christofel04/High-Precision-Oscillator-Circuit/messageImage_1573116734108.jpg

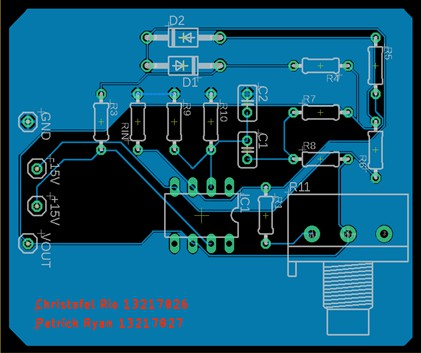
messageImage_1573116734108.jpg
