christofel04/High-Precision-Oscillator-Circuit/EL3109_06_13217026.pdf

Laporan Praktikum - Laboratorium Dasar Teknik Elektro – STEI ITB 1

MODUL 6 Mendesain Osilator RC Christofel Rio Goenawan (13217026) Asisten: Yoseph A. Adel P. (13216048) Tanggal Percobaan: Rabu, 30 Oktober 2019 EL3109- Praktikum Elektronika II

### Laboratorium Dasar Teknik Elektro - Sekolah Teknik Elektro dan Informatika ITB

Abstrak

Pada zaman modern ini, segala sesuatu memakai sistem elektrik. Mulai dari alarm yang membangunkan kita, gadget di genggaman tangan Anda, hingga pengendali pesawat luar angkasa memakai sistem elektris. Salah satu sistem yang paling sering dipakai dalam rangkaian elektrik adalah sistem osilator. Secara singkat sistem osilator adalah sistem rangkaian elektrk yang mengubah input arus atau tegangan searah menjadi arus atau tegangan bolak- balik
pada | outputnya. | Pada | umumnya | sistem | osilator
menggunakan komponen resistor, kapasitor, dan operating amplifier atau biasa disebut “op amp”. Selain rangkaian osilator pada umumnya, terdapat juga rangkaian osilator dengan umpan balik yang menawarkan berbagai kelebihan seperti pengaturan osilasi, pengaturan amplifikasi, dan pengaturan noise. Sistem osilator sangat berguan dalam dunia elektronika karena mengubah sumber DC yang diterima sebuah benda menjadi sinyal AC yang dapat dimanfaatkan dalam berbagai hal. Karena kegunaannya yang sangat penting dalam dunia elektro tersebut, maka penting bagi seorang engineer elektro untuk dapat menguasai cara analisis rangkaian osilator dengan umpan balik, karakteristik rangkaian osilator dengan umpan balik, dan mampu merancang suatu rangkaian osilator dengan umpan balik untuk suatu kebutuhan tertentu. Karena alasan- alasan di atas, maka penulis akan melakukan percobaan modul 4 ini. Diharapkan dengan adanya percobaan modul 4 ini maka penulis akan mengerti karakteristik rangkaian osilator dengan umpan balik, mampu menganalisis suatu rangkaian osilator dengan umpan balik, dan mampu mendesain suatu rangkaian osilator dengan umpan balik tertentu untuk
memenuhi | suatu | kebutuhan | tertentu.

Kata kunci: Rangkaian Elektrik, Rangkaian Osilator dengan Umpan Balik, Analisis, Mendesain, Menguasai.

### 1. PENDAHULUAN

Seperti yang telah dibahas sebelumnya, sistem elektrik menjadi kebutuhan tiap manusia saat ini. Dalam sistem elektrik, rangkaian elektrik adalah ‘roh’ . Dalam dunia rangkaian elektrik, Salah satu sistem yang paling sering dipakai dalam rangkaian elektrik adalah sistem osilator. Secara singkat sistem osilator adalah sistem rangkaian elektrik yang mengubah input arus atau tegangan searah menjadi arus atau tegangan bolak- balik pada outputnya. Pada umumnya sistem osilator menggunakan komponen resistor, kapasitor, dan operating amplifier atau biasa disebut “op amp”. Selain rangkaian osilator pada umumnya, terdapat juga rangkaian osilator dengan umpan balik yang menawarkan berbagai kelebihan seperti pengaturan osilasi, pengaturan amplifikasi, dan pengaturan noise. Sistem osilator sangat berguna dalam dunia elektronika karena mengubah sumber DC yang diterima sebuah
benda | menjadi | sinyal | AC | yang | dapat
dimanfaatkan dalam | berbagai | hal. Karena
kegunaannya yang sangat penting dalam dunia elektro tersebut, maka penting bagi seorang engineer elektro untuk dapat menguasai cara analisis rangkaian osilator dengan umpan balik, karakteristik rangkaian osilator dengan umpan balik, dan mampu merancang suatu rangkaian osilator dengan umpan balik untuk suatu kebutuhan tertentu. Karena alasan- alasan di atas, maka penulis akan melakukan percobaan modul 4 ini.

Dengan alasan- alasan di atas, maka penulis akan melakukan percobaan modul 6 ini. Secara umum terdapat 1 percobaan pada praktikum ini, yaitu: I) Pencobaan mendesain osilator Wien.

Pada percobaan pertama, yaitu percobaan mendesain osilator Wien, Penulis akan memasang rangkaian penguat common emitter dengan kapasitor bypass tepat seperti pada modul, kemudian Penulis akan mengukur sinyal output, penguatan, frekuensi cut- off dan resistansi input rangkaian tersebut. Kemudian Penulis akan mengubah rangkaian tersebut menjadi rangkaian transistor dengan umpan balik, kemudian Penulis akan kembali mengukur parameter seperti sebelumnya. Terakhir, Penulis akan mengubah rangkaian menjadi rangkaian dengan umpan balik
lainnya, | lalu | mengukur | parameter | seperti
sebelumnya sesuai dengan jenis umpab balik rangkaian tersebut. Tujuan dari percobaan ini adalah agar Penulis memahami cara kerja umpan
balik | pada rangkaian, memahami jenis- jensi
rangkaian | umpan | balik | transistor | dan
karakteristik | masing- | masing, | mampu
menganalisis kerja rangkaian transistor dengan umpan balik, dan mampu mendesain suatu rangkaian umpan balik transistor untuk suatu pekerjaan tertentu.

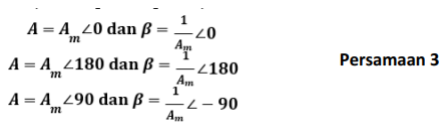
[picture p2: figure]
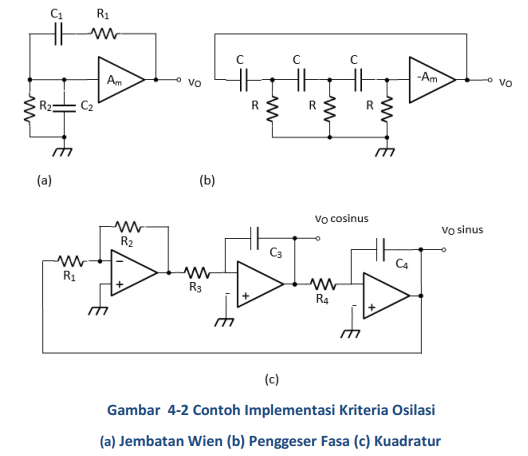
[picture p3: figure]
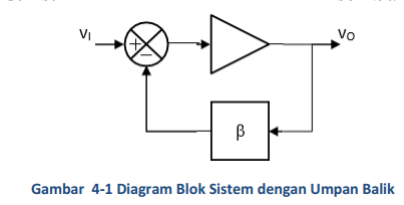
[picture p4: figure]

Laporan Praktikum - Laboratorium Dasar Teknik Elektro – STEI ITB 2

### 2. STUDI PUSTAKA

### 2.1 RANGKAIAN OSILATOR

Ada banyak cara untuk mencapai kriteria
terjadinya | osilasi | di | atas, | namun | untuk
kemudahannya dalam perancangan sering kali dipilih keadaan-keadaan berikut:

Contoh implementasi untuk ketiga keadaan tersebut di atas, secara berurutan adalah Osilator Jembatan Wien, Osilator Penggeser Fasa, dan Osilator Kuadratur yang rangkaian umumnya tampak pada Gambar 4-2.

Osilator Jembatan Wien secara umum mempunyai
frekuensi | osilasi | dan | penguatan | yang
diperlukan untuk terjadinya osilasi sebagai berikut:

Dalam realisasinya, dalam merancang Osilator Jembatan Wien sering kali dipilih R1=R2=R dan C1=C2=C sehingg frekuensi osilasinya menjadi ω=1/CR dan penguatan yang diperlukan Am=3. Nilai lain yang juga sering digunakan adalah R1=R, R2=10R, C1=C/10, dan C2=10C dengan frekuensi osilasi yang sama yaitu ω=1/CR namun
penguatan | hanya | Am=1,2.
Untuk Osilator Penggeser Fasa frekuensi osilasi dan penguatan yang diperlukan adalah

Sedangkan untuk osilator kuadratur frekuensi osilasinya adalah

dan untuk masing-masing integrator (inverting dan noninverting) penguatannya adalah

Dalam perancangannya bila dipilih R1=R2=R, R3=R4 dan C3=C4 maka diperoleh penguatan pada
masing-masing opamp 1 (satu) dan penguatan loop terbuka juga 1 (satu)

### 2.2 RANGKAIAN OSILATOR DENGAN

UMPAN BALIK

Sistem dengan umpan balik secara umum dapat
digambarkan | dengan | diagram | blok | pada
Gambar | | 4-1 | | berikut.

Blok A merupakan fungsi transfer maju dan blok merupakan fungsi transfer umpan baliknya. Pada sistem dengan umpan balik ini dapat diturunkan penguatan tegangannya:

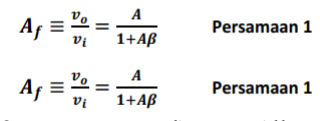
[picture p5: figure]
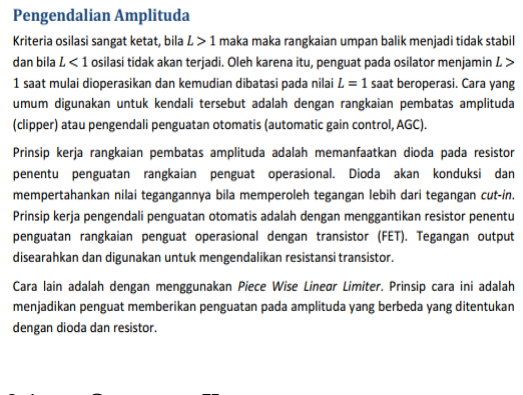
[picture p6: figure]

Laporan Praktikum - Laboratorium Dasar Teknik Elektro – STEI ITB 3

Secara umum persamaan di atas menunjukkan adanya tiga keadaan yang ditentukan oleh denominatornya. Salah satu keadaan tersebut adalah saat denominator menjadi nol. Saat itu nilai Af menjadi tak hingga. Secara matematis pada keadaan ini bila diberikan sinyal input nol atau vi=0 ini, akan menjadikan tegangan vo dapat bernilai berapa saja. Keadaan seperti inilah yang menjadi prinsip pembangkitan sinyal atau osilator sinusoidal dengan umpan balik yang disebut sebagai Kriteria Barkhausen. Dalam rangkaian kriteria tersebut dilihat dari total
penguatan | loop | terbuka | L | sbb.:

### 2.3 PENGENDALIAN AMPLITUDO PADA

RANGKAIAN OSILATOR DENGAN
UMPAN BALIK

### 2.4. OSILATOR KUADRATUR

Untuk menghasilkan keluaran quadrature dari rangkaian osilator cincin single ended diperlukan jumlah tahap yang genap,tetapi jumlah tahap yang genap tidak akan bisa berosilasi karena mempunyai keadaan stabil yang disebut latch-up. Untuk mencegah keadaan latch up, yang pertama dengan menggunkan sel tunda CML(current mode logic) yang
mempunyai sebuah transistor tail current source [16]. Cara kedua dengan menggunakan teknik injection locking. Cara
ketiga dengan menambahkan jalur feed forward atau subfeedback pada nodal yang mempunyai fase berlawanan [10].
Cara pertama mempunyai kelemahan, yaitu konsumsi daya yang lebih besar karena penggunaan arus bias yang konstan
pada transistor tail, sedangkan injection locking memerlukan input berupa sinyal diferensial. Oleh karena itu dalam paper
ini digunakan cara ketiga yaitu menambahkan jalur atau kalang umpan balik sub-feedback. Osilator rancangan menggunakan single-ended inverter empat tahap untuk menghasilkan keluaran quadrature,
meskinpun dapat juga dilihat sebagai differential inverter dua tahap dengan sub-feedback index x = 3 [11]. Di mana x
merepresentasikan jumlah inverter dalam kalang umpan balik.

Dalam rancangan ini, rangkaian umpan balik terdiri dari INV2, INV3 dan f2. Dengan membentuk kalang umpan balik subfeedback dua buah sinyal dengan fase yang berbeda 1800 akan bertemu sehingga membentuk sebuah rangkaian regenerative
yang akan membuat osilator dengan jumlah tahap yang genap 56 JNTETI, Vol. 1 No. 2, Agustus 2012 ISSN 2301 – 4156 Rangkaian Osilator Cincin... tetap bisa berosilasi dan mengeluarkan sinyal. Kalang Subfeedback juga bisa digunakan untuk membuat jalur cepat sehingga mengurangi waktu tunda dan akibatnya bias meningkatkan frekuensi [10], [11]. Hal ini bisa dijelaskan sebagai berikut, ketika keluaran dari INV2 belum mencapai tegangan ambang (threshold), keluaran dari f2 sudah mencapai tegangan ambang terlebih dahulu, sehingga tegangan keluaran pada X2 dapat mencapai tegangan ambang terlebih dahulu sesuai dengan tegangan keluaran dari f2, sehingga menyebabkan periode sinyal keluaran atau waktu tunda menjadi lebih kecil dan akhirnya dapat meningkat kan frekuensi keluaran.

### 3. METODOLOGI

### 3.1. ALAT DAN BAHAN

Berikut alat dan bahan yang dipakai pada percobaan ini.

1. Kit Praktikun Osilator Sinusoidal
2. 1x Generator Sinyal 2 channel
3. 2 x Sumber Tegangan DC
4. 1x Osiloskop 2 channel
5. 1x Multimeter Digital SANWA CD800A
6. 1x Multimeter Analog SANWA YX360TRF

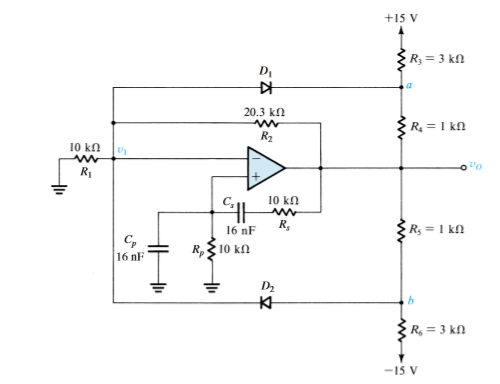
[picture p7: figure]
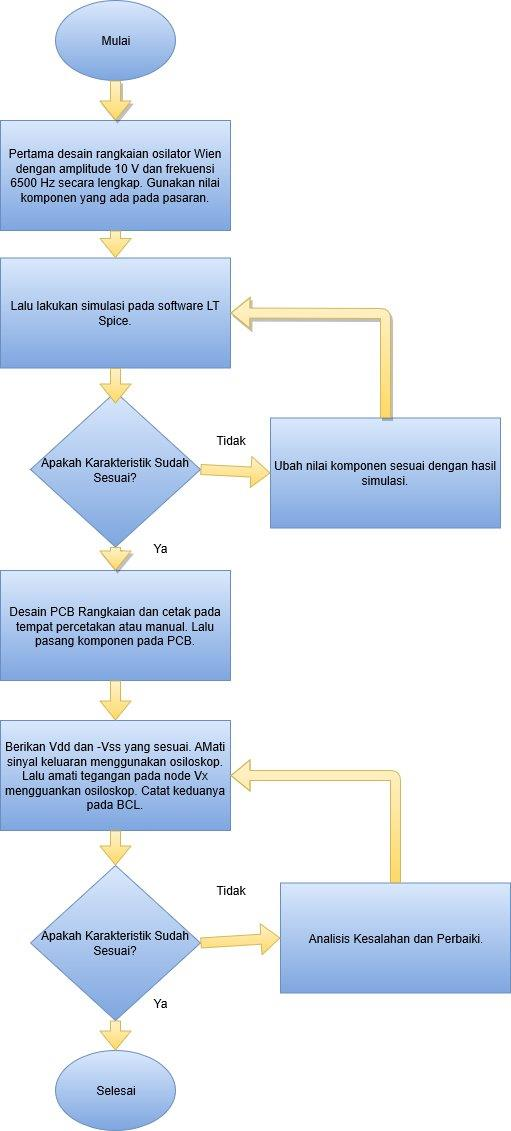
[picture p8: figure]

Laporan Praktikum - Laboratorium Dasar Teknik Elektro – STEI ITB 4

7. 1x Multimeter Bench
8. 1x Aerosol Udara Terkompresi
9. 1x Resistor Variabel
10. Kabel BNC- BNC, BNC- Buaya,
Buaya- | Buaya, | jumper
secukupnya

### 3.2. LANGKAH PERCOBAAN

### 3.2.1 PERCOBAAN 1: PERCOBAAN MENDESAIN

OSILATOR WIEN

Alat yang dibutuhkan: Kit Praktikum Osilator Sinusoidal, Generator Sinyal 2 channel, Sumber Tegangan DC, Osiloskop 2 channel, 3 macam Multimeter, kabel dan jumper secukupnya.

Langkah Percobaan:

### 3.3. DESAIN RANGKAIAN

Penulis akan mendesain suatu osilator Wien dengan frekuensi 6,5 KHz dan amplitude output 10 V. Untuk mendesain osilator Wien dengan amplitude tertentu Penulis menggunakan rangkaian osilator Wien dengan diode sebagai pembatas tegangan sederhana. Rangkaian umum osilator ini adalah sebagai berikut [1, halaman 1390].

Berdasarkan teori dapat kita lihat bahwa penurunan penguatan loop gain rangkaian di atas dengan mengabaikan diode dan resistor 5 dan 6 adalah sebagai berikut ( misalkan feedback R2 dipotong dan diberi tegangan sebesar Vt ). Dengan KCL pada node V1 (dengan asumsi op amp ideal sehingga tidak ada arus yang mengalir pada input negative dan positif dan tegangan pada kedua input sama):

V1/R1 = (Vt – V1)/R2

- V1/Vt = R1/(R1+R2)

Kemudian dengan KCL pada node Vo:

(Vo – V1 )/(Rs + 1/(Cs*s)) = V1/(1/(1/Rp + Cp*s))

Dengan memasang Cp= Cs dan Rp = Rs didapat turunan sebagai berikut.

- Vo/ V1 = 3 + RCs + 1/(RCs)

Dengan mengalikan dua persamaan didapat hubungan sebagai berikut.

Laporan Praktikum - Laboratorium Dasar Teknik Elektro – STEI ITB 5

L= V0/Vt

= Vo/V1 * V1/Vt

= (R1/(R1+R2)) * (3 + RCs + 1/(RCs))

- L(Wj) = (R1/(R1+R2)) * (3 + j(RCW – 1/(RCW)))

Berdasarkan teori pada referensi [1, halaman 1389] didapat bahwa osilasi terjadi hanya saat nilai L adalah bilangan real dan nilainya tepat sama dengan 1. Maka didapatkan sebagai berikut.

i) Im(L) = 0

Maka haruslah RCW – 1/RCW = 0, yang ekivalen sebagai berikut.

RCW = 1/RCW

- W = 1/RC

ii) Re(L) =1

Maka haruslah sebagai berikut.

3*R1/(R1+R2) = 1

- 3*R1 = R1 + R2
- R2 = 2*R1

Sedangkan untuk mengatur amplitudonya, digunakan diode seperti pada gambar di atas. Adapun cara kerja pembatas diode adalah pada saat tegangan positif maksimal ( Vmax) tegangan pada node b akan melebihi tegangan pada V1 ( yang berdasar teori seharusnya 1/3* Vo) dan diode D2 akan konduksi. Hal ini akan membuat tegangan maksimal akan ditentukan oleh nilai resistor R5 dan R6 dan tegangan – Vss sebagai berikut.

Vb = V1 + Vd2

Dengan Vd2 adalah tegangan drop voltages pada diode D2 saat forward biase. Sehingga hal dengan mengasumsikan Vd2 = 0,7 V maka dengan KCL pada node b didapat output persamaan sebagai berikut.

Vb – (-Vss)/R6 = (Vo – Vb)/R5

- (Vo/3 + 0,7 -(- Vss) )/R6 = (Vo – Vo/3 – 0,7)/R5

Dengan menggunakan nilai Vdd= 15 V dan – Vss = -15 V didapat hubungan sebagai berikut.

(Vo/3 + 15,7)/R6 = (2/3 * Vo – 0,7)/R5

- Vo = 3*(15,7/R6 + 0,7/R5)/(2/R5 – 1/R6)
- Vo = 3*(15,7 *R5 + 0,7*R6)(2*R6-R5)

Adapun untuk tegangan minimum sama dengan perhitungan tegangan maksimum.

Dari persamaan di atas dapat kita rancangan osilator Wien dengan karakteristik sebagai berikut.

i) F = 6500 Hz

Maka didapat hubungan:

F = W/2*pi

= 1/(2*pi*R*C)

Karena nilai kapasitor sangat mudah berubah akibat lingkungan [15], maka akan digunakan nilai kapasitor yang cukup kecil sehingga tidak mudah mengubah karakteristik rangkaian. Maka akan dipilih C= 22nF karena nilai cukup kecil dan mudah didapat. Dengan memasukkan C = 22 nF didapat hubungan sebagai berikut.

6500 = 1/(2*pi*R*22.10^(-9))

- R = 1112,97163 Ohm

Berdasarkan nilai resistor E24 hal ini dapat diimplementasikan dengan 2 resistor 2200 Ohm diparaler yang ekivalen 1100 Ohm, cukup mendekati nilai perhitungan.

Maka didapatkan bahwa Cp = Cs = 22nF dan Rp = Rs = 1100 Ohm yang akan diimplementasikan dengan mem- paralelkan 2 resistor 2200 Ohm.

ii) | Persamaan Osilasi terpenuhi
Berdasarkan | referensi | pada | [16] | pada
prakteknua digunakan nilai L yang tidak tepat 1 , tapi sedikit di atas 1. Hal ini dikarenakan
mengantisipasi | jika | perubahan | lingkungan
megakibatkan | perubahan | nilai | komponen
sehingga menurunkan L, maka osilasi akan langsung teredam. Sehingga pada nilai R2 dan R1 dengan hubungan sebagai berikut.

R2 = 2* R1

Akan digunakan nilai R1 cukup besar sehingga nilai R2 dapat ditambah sedikit di atas 2*R1, yaitu

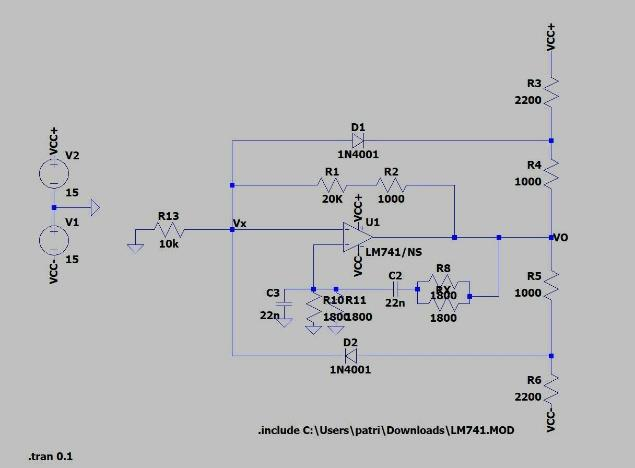
[picture p9: figure]
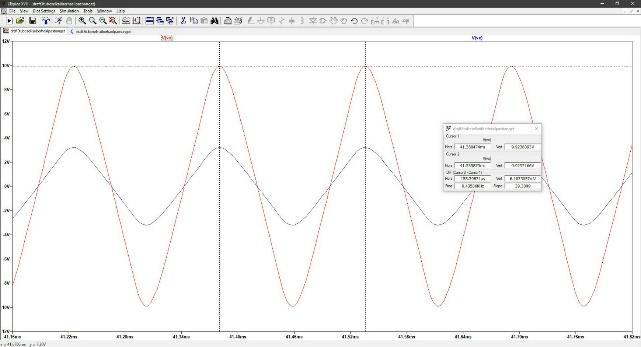
[picture p10: figure]
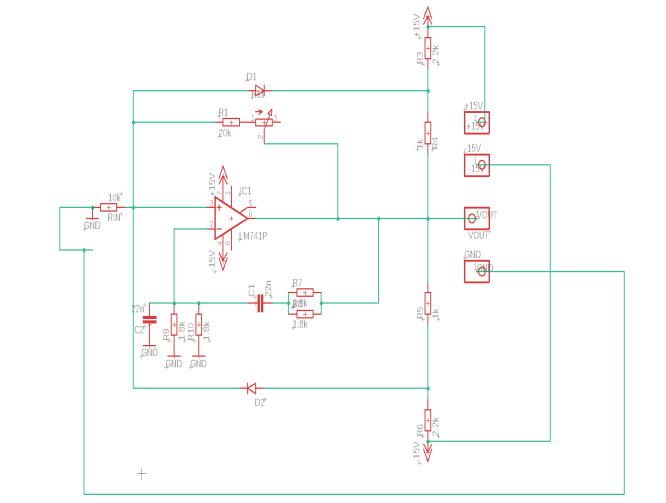
[picture p11: figure]

Laporan Praktikum - Laboratorium Dasar Teknik Elektro – STEI ITB 6 dipilih R1 = 10K Ohm maka R2 = 20KOhm + e dengan nilai e cukup kecil. Untuk mengantisipasi perubahan nilai komponen pada rangkaian karena factor eksternal maka Penulis memutuskan mengguankan R2 dengan resistor 20KOhm dan sebuah potensiometer dengan range 0 sampai 10 KOhm.

iii) Vo = 10V

Karena diinginkan Vo = 10V maka persamaan menjadi sebagai berikut.

10 = 3*(15,7 *R5 + 0,7*R6)(2*R6-R5)

- R6 = 3,1983 * R5

Dari hubungan di atas untuk meningkatkan akurasi R6/R5 maka akan digunakan R6 cukup besar tetapi tidak terlalu besar karena semakin besar nilai resistor maka error akan semakin besar sehingga nilai R6/R5 akan semakin berubah. Hal ini membuat R5 dipilih 1 KOhm, sehingga R6 sekitar 3198,3 Ohm. Dengan melihat nilai resistor E24, maka akan digunakan nilai resistor R6 = 3,3 KOhm.

Kemudian Penulis melakukan simulasi dengan nilai komponen seperti di atas pada LT Spice, dengan D1 dan D2 menggunakan diode 1N4001 (karena umum di pasaran ) dan op amp LM741. Tetapi pada saat melakukan percobaan di dapat bahwa hasil kurang sesuai dengan tujuan yaitu frekuensi 7300 Hz dan amplitude 9,3 V. Hal ini dapat dijelaskan karena demi menggunakan nilai pasaran maka dilakukan berbagai estimasi seperti pada menentukan nilai Rp dan Rs dan menetukan nilai R6. Selain itu pada simulasi tegangan drop voltage diode 1N4001 adalah sekitar 1 V, cukup jauh dengan asumsi 0,7 V yang digunakan. Selain itu penurunan yang digunakan Penulis merupakan pendekatann terhadap pole dan zero transfer rangkaian sehingga seringkali terjadi perbedaan dengan hasil analisis yang melakukan simulasi secara fungsional [17]. Maka Penulis mengubah-ubah sedikit nilai resistor Rp dan Rs, dan nilai R6. Maka didapatkan perubahan sebagai berikut.

Rp = Rs = 1100 Ohm => Rp= Rs = 900 Ohm

R6 = 3300 Ohm => R6 = 2200 Ohm

Dan diapatkan output dengan frekuensi 6432 Hz dan amplitude 9,95 V.

Sehingga desain akhir yang Penulis gunakan adalah sebagai berikut beserta dengan hasil simulasi V output nya.

### 3.4. DESAIN PCB

Berdasarkan skematik yang dibuat sebagai berikut:

Dalam mendesain PCB in, Penulis membuat supaya tidak Ada jalur Yang bersudut 90 derajat Karena jalur Yang bersudut 90 derajat Akan mengganggu jalannya arus pada frekuensi Yang cukup tinggi, tetapi Penulis Akan membuat

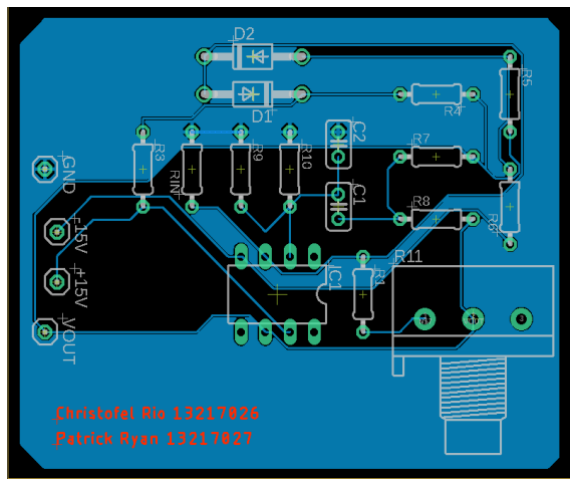
[picture p12: figure]
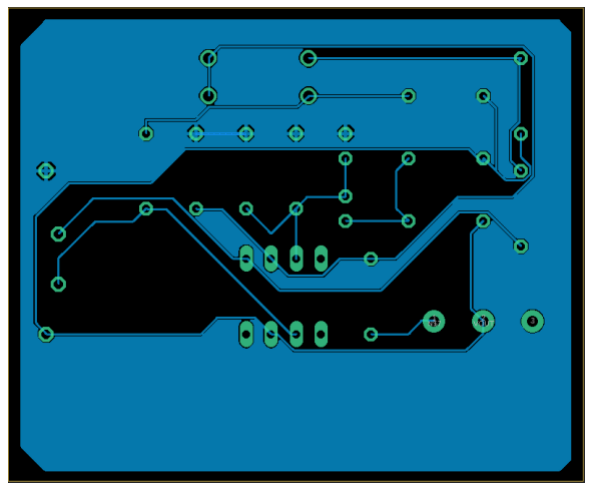
[picture p13: figure]

Laporan Praktikum - Laboratorium Dasar Teknik Elektro – STEI ITB 7 supaya banyak jalur memiliki sudut 45 derajat Karena sudut ini adalah sudut Yang paling baik Dalam jalur PCB. Selain itu, Penulis Akan memakai ground plane Dalam PCB untuk
mengurangi | noise | Dalam | rangkaian | dan
memasang port input, output dan potentiometer pada tepi- tepi PCB untuk mempermudah pemakaian. Selain itu Penulis juga akan membuat jarak antar kapasitor tidak cukup dekat sehingga tidak terjadi kapasitor mutual.
Hasil Desain PCB dari skematik tersebut adalah sebagai berikut:
- Top Layer:

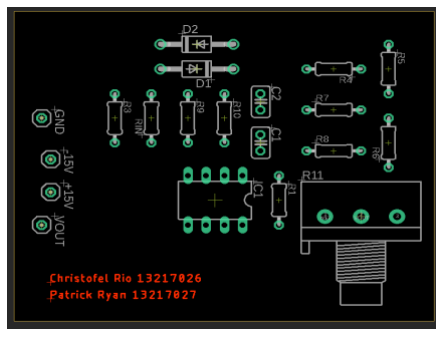
[picture p14: figure]

- Bottom Layer:
- Overall View:

Digunakan Ground plane, dimana pada gambar dapat ditandai dengan warna biru, terletak pada bottom layer. Ukuran PCB adalah 47,92 x 58,41 mm.

### 3.5. RINCIAN BIAYA

Seperti yang telah disebutkan pada
perencanaan | desain | Penulis | memutuskan
menggunakan resistor dengan toleransi 1% untuk menjaga karakteristik resistor dari perubahan lingkungan dank arena harga resistor dengan toleansi 1% dan 5% hanya berbeda Rp 20,00 per
butir. | Selain | itu | Penulis | memutuskan
menggunakan masking pada PCB sehingga PCB lebih aman dari tekanan dan efek dari luar meskin menambah harga cukup signifikan. Selain itu Penulis menggunakan PCB dengan FR 4 untuk mengantisipasi kesalahan solder dari Penulis.

Adapun rincian biaya sebuah osilator yang dibuat adalah sebagai berikut.

No | Nama | Ban yak | Harga/ Pcs | Harga
1 | Pembuatan PCB FR 4 + Masking + Lettering | 1 | Rp 26.000,0 0 | Rp 26.000, 00
2 | Op Amp LM 741 + Socket | 1 | Rp 2.500,00 | Rp 2.500,00
3 | Pin Male Header | 3 | Rp 33,00 | Rp 100,00

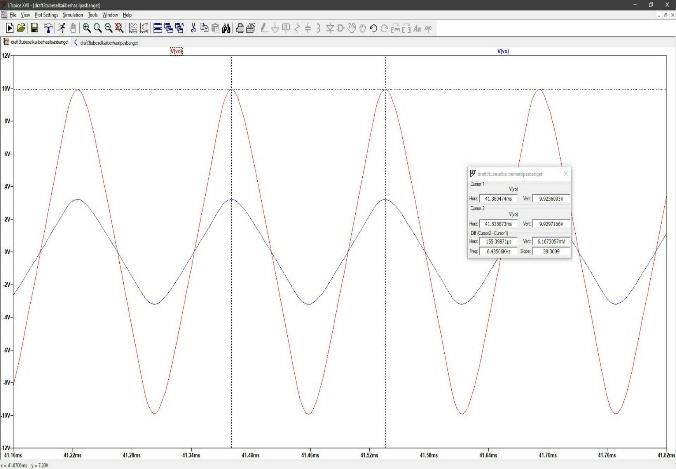
[picture p15: figure]
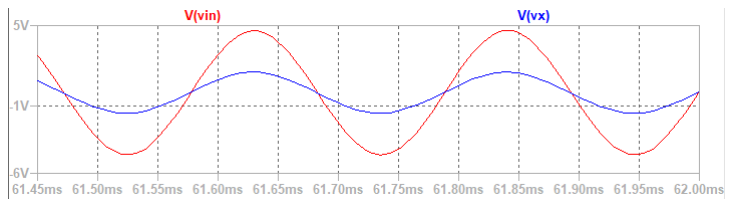
[picture p16: figure]

Laporan Praktikum - Laboratorium Dasar Teknik Elektro – STEI ITB | 8
4 | Dioda 1N4001 | 2 | Rp 1.200,00 | Rp 2.400,00
5 | Resistor 20 KOhm | 1 | Rp 100,00 | Rp 100,00
6 | Resistor 10 KOhm | 1 | Rp 100,00 | Rp 100,00
7 | Potensiome ter 0- 10 KOhm | 1 | Rp 2.500,00 | Rp 2.500,00
8 | Resistor 1800 Ohm | 4 | Rp 100,00 | Rp 400,00
9 | Resistor 1000 Ohm | 2 | Rp 100,00 | Rp 200,00
10 | Resistor 2200 Ohm | 2 | Rp 100,00 | Rp 200,00
11 | Kapasitor Film 22 nF | 2 | Rp 1000,00 | Rp 2000,00
Total Harga | | | | Rp 36.500,00

### 4. HASIL DAN ANALISIS

Berikut data hasil percobaan yang didapat.

### 4.1. PERCOBAAN 1: PERCOBAAN KARAKTERISTIK

RANGKAIAN OSILASI

Pertama, Penulis memasang rangkaian yang telah dibuat pada PCB dengan rangkaian sebagai berikut.

A) RANGKAIAN 1
Lalu | Penulis | melakukan | simulasi
percobaan yang akan dilakukan menggunakan software LT Sice XVII, dan didapatkan hasil percobaan sebagai berikut.

Didapatkan nilai resistor feedback yang membuat osilasi adalah sekitar 20,3 KOhm dengan output sinusoidal dengan amplitude output 9,8 V dan frekuensi 6,432 KHz sebagai berikut.

Kemudian Penulis melakukan simulasi tegangan pada node x dan didatakan hasil sebagai berikut,

Dari hasil simulasi di atas dapat kita lihat bahwa tegangan pada V node adalah tegangan sinusoidal dengan frekuensi 6,432 KHz dan amplitude 3,265
V. Hal ini sesuai dengan asumsi yang digunakan pada desain osilator yaitu tegangan Vx adalah sekitar sepertiga dari tegangan V output.
Lalu, | Penulis mengukur | komponen-
komponen yang akan digunakan pada percobaan 1 dan didapatkan hasil pengukuran sebagai berikut.

Percobaan 1

Vdd (V) | Vss (V) | Q1 (Ohm)
15,00 | -15,00 | LM 741
D1 | D2 | R1 (Ohm)
1N4001 | 1N4001 | 9985 Ohm

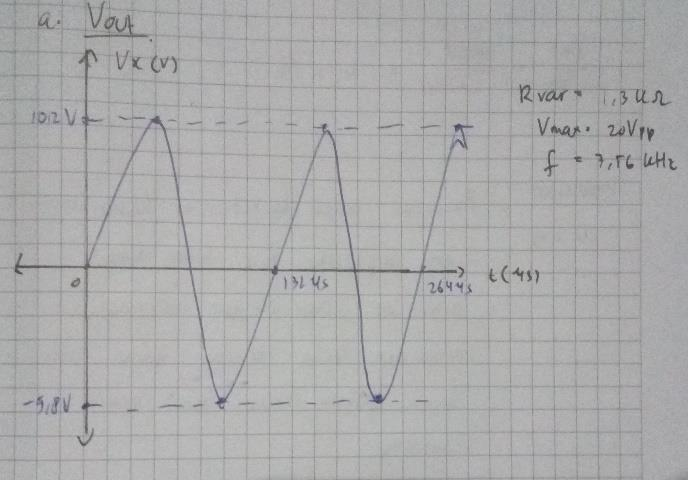
[picture p17: figure]
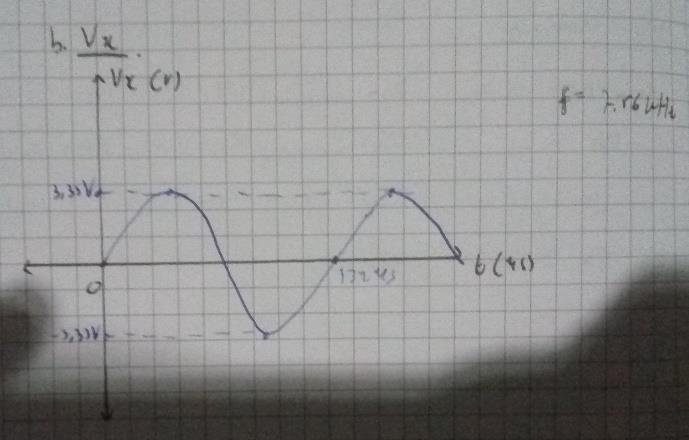
[picture p18: figure]

Laporan Praktikum - Laboratorium Dasar Teknik Elektro – STEI ITB 9

R2

(Ohm)

Rvar

(Ohm)

R31,32

(Ohm)

20,01 K | 1300 | 1810
R41 (Ohm) | R42 (Ohm) | R51 (Ohm)
1811 | 1813 | 1005
R52 (Ohm) | R61 (Ohm) | R62 (Ohm)
1010 | 3298 | 3272

Lalu, berikut hasil percobaan yang Penulis dapatkan.

1) RANGKAIAN 1
A. VOUT
B. VX

RANGKAIAN 1

VOUT

RF

(OHM)

F

(HZ)

AMPLITUDO

21,3 K | 7,56 KHZ | 10 V
| VX
VOUT | F (HZ)
3,331 V | 7,54 KHZ
VOUT/ VX | 3,01 V/V

Dari hasil percobaan di atas dapat kita lihat bahwa pada rangkaian pertama, berdasarkan dasar teori bab 2.1 didapatkan nilai frekuensi saat:

Didapatkan nilai

W = 1/ sqrt (R1 * R2 * C1 * C2)

Karena R1= R2 dan C1 = C2 didapat sebagai berikut.

= 1/ R* C

= 1/ (900 * 900 *22* 10^(-9))

= 25.252,525 rad/s

- F = W/ 2. Pi

= 4019 Hz

AM = 1 + C2/C1 + R1/R2

= 3

Adapun pada hasil percobaan di atas, dapat kita lihat bahwa nilai frekuensi cukup jauh berbeda antara perhitungan tangan, hasil percobaan dan hasil simulasi ( yaitu 7565 Hz dan 6432 Hz ). Adapun perbedaan cukup besar ini dapat dijelaskan karena perbedaan nilai resistor pada simulasi dengan nilai komponen pada percobaan, yaitu nilai resistansi dan kapasitansi sebenarnya lebih kecil dari nilai C dan R pada simulasi ( dapat dilihat pada table ), sehingga didapatkan nilai frekuensi osilasi yang lebih besar. Sementara itu perbedaan cukup besar antara simulasi ( 6432 Hz )

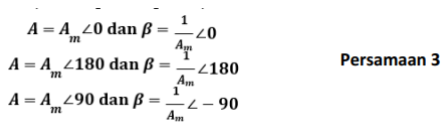
[picture p19: figure]

Laporan Praktikum - Laboratorium Dasar Teknik Elektro – STEI ITB 1
0

dengan hasil percobaan ( 7565 Hz ) dapat dijelaskan nilai kapasitor yang sangat sensitif terhadap lingkungan, yaitu suhu dan kelembapan [15]. Hal ini mengakibatkan nilai C dapat bergeser hingga 15 % [15] dan mengakibatkan nilai F dapat bergeser sekitar 13,04 persen. Hal ini semakin dikuatkan karena ketika Penulis mengukur kapasitansi kapasitor menggunakan multimeter bench pada laboratorium dasar ditemukan bahwa nilai Cp dan Cs adlaah sekitar 25,1 nF yaitu bergeser sekitar 14,8%. Hal ini mengakibatkan nilai frekuensi bergeser sekitar 10% , dan cukup sesuai dengan hasil percobaan yang didapat.

Selain itu berdasarkan rumus penurunan pada bab 3.1 didapat persamaan sebagai berikut.

Vb – (-Vss)/R6 = (Vo – Vb)/R5

Dengan tegangan node b dapat dinyatakan sebagai berikut.

Vb = V1 + Vd2

Dengan Vd2 adalah tegangan drop voltage diode pada saat forward biase. Dengan melihat datasheet diode 1N4001 didapatkan bahwa tegangan drop dioda adalah sekitar 1V pada suhu STP, maka didapatkan nilai sebagai berikut.

Vb = (3,331 V ) + (1V) = 4,331 V

Maka persamaan menjadi sebagai berikut.

(4,331V + 15V)/2200 Ohm = (Vo – 4,331 V )/ 1000 Ohm

- Vo = 13,1178 V

Adapun pada hasil percobaan di atas, dapat kita lihat bahwa hasil percobaan dan hasil simulasi hampir sama tapi terdapat perbedaan cukup jauh pada perhitungan manual ( 10,0 V dan 9,95 V ). Hal ini kembali disebabkan karena perbedaan
nilai | resistor | pada | simulasi dengan nilai
komponen pada percobaan, yaitu nilai rasio R5/R6 resistansi dan sebenarnya lebih kecil dan rasio R5/R6 pada simulasi ( dapat dilihat pada table ), sehingga didapatkan nilai tegangan yang lebih kecil yang lebih besar. Selain itu kembali hal ini disebabkan karena hasil perhitungan manual memiliki banyak asumsi yang digunakan, seperti op amp ideal ( di mana pada prakteknya tidak mungkin terjadi ) sehingga terdapat drop arus dan tegangan pada input op amp yang membuat hasil perhitungan manual lebih besar dari hasil simulasi dan percobaan.

Selain itu dapat kita lihat bahwa nilai penguatan open loop gain ( AM) pada rangkaian 1 adalah sebesar 0,327, yang sesuai dengan hasil perhitungan tangan yaitu penguat open loop adalah 3, sehingga nilia VX seharusnya = (penguatan open loop)/3 = 1/3 = 0,33 ( hal ini juga sesuai dengan hasil simulasi ). Adapun kembali perbedaan kecil disebabkan karena keterbatas pengukuran osiloskop ( yaitu memiliki toleransi dan hambatan dalam ).

Selain itu, dapat kita lihat bahwa terjadi perbedaan kecil antara frekuensi rangkaian ketika close loop dan open loop ( 7,565 KHz dan 7,54 KHz ). Hal ini dapat dijelaskan karena pengukuran frekuensi pada osiloskop sangat mudah berubah karena adanya noise , sehingga hasil perhitungan pada frekuensi menjadi sedikit bergeser ( biasanay menjadi lebih tinggi [15] ).

Lalu, berdasarkan hasil pengamatan Lissajouis pada percobaan, dapat kita lihat bahwa perbedaan fasa pada open loop sekitar 0 derajat. Hal ini dapat dijelaskan pada dasar teori bab 2.1, yang menyatakan bahwa:

Sehingga didapatkan tidak ada pergeseran fasa selama system osilator Wien bekerja ( yang juga sesuai dengan hasil simulasi ).

Dari hasil percobaan ini dapat kita lihat bahwa rangkaian osilator RC adalah rangkaian yang mengandug resistor dan kapasitor, dan memanfaatkan zero input pada rangkaian yang menghasilkan nilai output hingga tegangan Vdd untuk melakukan osilasi. Selain itu dapat kita lihat bahwa rangkaian osilator Wien adalah rangkaian osilator yang mengandung satu op amp dan
memiliki | penguatan | loop sebesar | 1, | dan
penguatan loop gain sepertiga saat semua nilai kapasitor dan resistor pada input sama. Selain itu dapat kita lihat bahwa pada rangkaian Wien tidak terjadi pergeseran fasa dan nilai frekuensi osilasi osilator bergantung pada nilai resistor dan kapasitor pada input negative op amp dengan hubungan seperti di atas. Selain itu dapat kita lihat bahwa amplitude pada osilator Wien dapat dibatasi dengan beberapa cara, salah satu yang

Laporan Praktikum - Laboratorium Dasar Teknik Elektro – STEI ITB 11 paling mudah dan sering dipakai adalah menggunakan dioda pada outputnya seperti yang digunakan pada percobaan ini. Selain itu dapat kita lihat bahwa osilator bekerja saat nilai penguatan loop gain (L) memiliki nilai tepat 1. Adapun pada prakteknya dibuat nilai penguatan sedikit di atas satu karena mengantisipasi jika nilai
komponen | pada | rangkaian | berubah | dan
penguatan tidak sampai satu. Selain itu hal ini
dapat | diantisipasi | dengan | menggunakan
potensiometer pada resistor feedback. Selain itu dapat kita lihat bahwa nilai kapasitor sangat bergantung lingkungan sehingga untuk menjaga karakteristik rangkaian digunakan nilai kapasitor yang kecil dan menggunakan resistor dengan toleransi yang sangat baik ( contohnya satu persen ). Selain itu dapat kita lihat bahwa pada mendesain PCB dibuat supaya jalur tidak memiliki sudut yang mendekati 90 derajat karena dapat mengganggu sinyal dengan frekuensi tinggi. Selain itu komponen yang menghasilkan medan dan dapat mengalamai induktansi mutual seperti kapasitor dan inductor diletakkan cukup jauh. Selain itu untuk mengurangi noise pada rangkaian dapat digunakan pouring pada PCB. Adapun untuk melindungi solder dari kesalahan saat solder dan factor eksternal lain dapat digunakan masking.

Karena hasil percobaan sesuai dengan teori maka dapat disimpulkan percobaan telah berhasil dengan baik. Yeyyy....

### 5. KESIMPULAN

Berdasarkan hasil percobaan dapat kita simpulkan beberapa kesimpulan.

Pada percobaan pertama, yaitu percobaan mendesain dan mengimplementasikan osilator Wien pada PCB dapat kita lihat bahwa rangkaian osilator RC adalah rangkaian yang mengandug resistor dan kapasitor, dan memanfaatkan zero input pada rangkaian yang menghasilkan nilai output hingga tegangan Vdd untuk melakukan osilasi. Selain itu dapat kita lihat bahwa rangkaian osilator Wien adalah rangkaian osilator yang mengandung satu op amp dan memiliki penguatan loop sebesar 1, dan penguatan loop gain sepertiga saat semua nilai kapasitor dan resistor pada input sama. Selain itu dapat kita lihat bahwa pada rangkaian Wien tidak terjadi pergeseran fasa dan nilai frekuensi osilasi osilator bergantung pada nilai resistor dan kapasitor pada input negative op amp dengan hubungan seperti di atas. Selain itu dapat kita lihat bahwa amplitude pada osilator Wien dapat dibatasi dengan beberapa cara, salah satu yang paling mudah dan sering dipakai adalah menggunakan dioda pada outputnya seperti yang digunakan pada percobaan ini. Selain itu dapat kita lihat bahwa osilator bekerja saat nilai penguatan loop gain (L) memiliki nilai tepat 1. Adapun pada prakteknya dibuat nilai penguatan sedikit di atas satu karena mengantisipasi jika nilai komponen pada rangkaian berubah dan penguatan tidak sampai satu. Selain itu hal ini dapat diantisipasi
dengan | menggunakan | potensiometer | pada
resistor feedback. Selain itu dapat kita lihat bahwa nilai kapasitor sangat bergantung lingkungan sehingga untuk menjaga karakteristik rangkaian digunakan nilai kapasitor yang kecil dan menggunakan resistor dengan toleransi yang sangat baik ( contohnya satu persen ). Selain itu dapat kita lihat bahwa pada mendesain PCB dibuat supaya jalur tidak memiliki sudut yang mendekati 90 derajat karena dapat mengganggu sinyal dengan frekuensi tinggi. Selain itu komponen yang menghasilkan medan dan dapat mengalamai induktansi mutual seperti kapasitor dan inductor diletakkan cukup jauh. Selain itu untuk mengurangi noise pada rangkaian dapat digunakan pouring pada PCB. Adapun untuk melindungi solder dari kesalahan saat solder dan factor eksternal lain dapat digunakan masking.
| Daftar Pustaka
[1] Adel S. Sedra dan Kennet C. Smith, Microelectronic Circuits, Oxford University Press, USA, 1997.
[2] https://en.wikipedia.org/wiki/Bipolar_junction_transistor (https://en.wikipedia.org/wiki/Bipolar_junction_transistor) , Rabu, 20 Februari 2019. 3.25.
[3] Adel S. Sedra dan Kennet C. Smith, Microelectronic Circuits, Oxford University Press, USA, 1997.
[4] https://www.electronics-tutorials.ws/transistor/tran_3.html (https://www.electronics-tutorials.ws/transistor/tran_3.html) , Rabu, 20 Februari 2019, 15.25.
[5] https://www.electronics-tutorials.ws/transistor/tran_2.html (https://www.electronics-tutorials.ws/transistor/tran_2.html) , Rabu, 20 Februari 2019, 15.30.
[6] https://www.petervis.com/Education/transistor-alpha-beta/transistor-alpha-beta.html (https://www.petervis.com/Education/transistor-alpha-beta/transistor-alpha-beta.html) , Rabu, 20 Januari 2019, 15.50.
[7] https://www.electronicshub.org/different-configurations-of-transistors/ (https://www.electronicshub.org/different-configurations-of-transistors/) , Rabu, 20 Februari 2019, 15.52.
[8] http://fourier.eng.hmc.edu/e84/lectures/ch4/node3.html (http://fourier.eng.hmc.edu/e84/lectures/ch4/node3.html) , Rabu, 20 Februari 2019, 15.54.
[9] https://www.slideshare.net/jessrangcasajo/bi polar-junction-transistor-bjt-dc-and-ac-analysis (https://www.slideshare.net/jessrangcasajo/bipolar-junction-transistor-bjt-dc-and-ac-analysis) , Rabu, 20 Februari 2019. 22.45.

Laporan Praktikum - Laboratorium Dasar Teknik Elektro – STEI ITB 12

[10] https://www.allaboutcircuits.com/technical-articles/bjts-after-biasing-the-small-signal-model/ (https://www.allaboutcircuits.com/technical-articles/bjts-after-biasing-the-small-signal-model/) , Rabu, 20 Februari 2019, 22.50.
[11] https://slideplayer.com/slide/6285846/ , Rabu, 20 Februari 2019, 22.55.
[12] https://en.wikipedia.org/wiki/Common_emi tter (https://en.wikipedia.org/wiki/Common_emitter) , Rabu, 20 Februari. 23.00.
[13] http://electronics-course.com/bjt-cb-amp , Rabu, 20 Februari 2019, 23.01.
[14] https://www.allaboutcircuits.com/textbook/semiconductors/chpt-4/common-collector-amplifier/ (https://www.allaboutcircuits.com/textbook/semiconductors/chpt-4/common-collector-amplifier/) . Rabu, 20 Februari 2019, 23.03.
[15] https://www.electronics-tutorials.ws/amplifier/amp_4.html (https://www.electronics-tutorials.ws/amplifier/amp_4.html) , abu, 20 Februari 2019, 23.15.
[16] https://en.wikipedia.org/wiki/Early_effect , Rabu, 20 Februari 2019, 15.56.
[17] https://www.allaboutcircuits.com/technical-articles/understanding-the-early-effect/ (https://www.allaboutcircuits.com/technical-articles/understanding-the-early-effect/) , Rabu, 20 Februari 2019, 15.58.
[18] Hutabarat, Mervin et al. Petunjuk Praktikum Rangkaian Elektronika II. 2019.
[19] https://forum.allaboutcircuits.com/threads/bjt-op-amp-current-source-issue.147905/ (https://forum.allaboutcircuits.com/threads/bjt-op-amp-current-source-issue.147905/) , Rabu, 16 Oktober 2019, 21.03.
[20] http://www.learnabout-electronics.org/Amplifiers/amplifiers31.php (http://www.learnabout-electronics.org/Amplifiers/amplifiers31.php) , Ranu. 16 Oktober 2019, 21.15.
