christofel04/High-Precision-Oscillator-Circuit/Hasil_Simulasi_Vout_Jadi.jpg

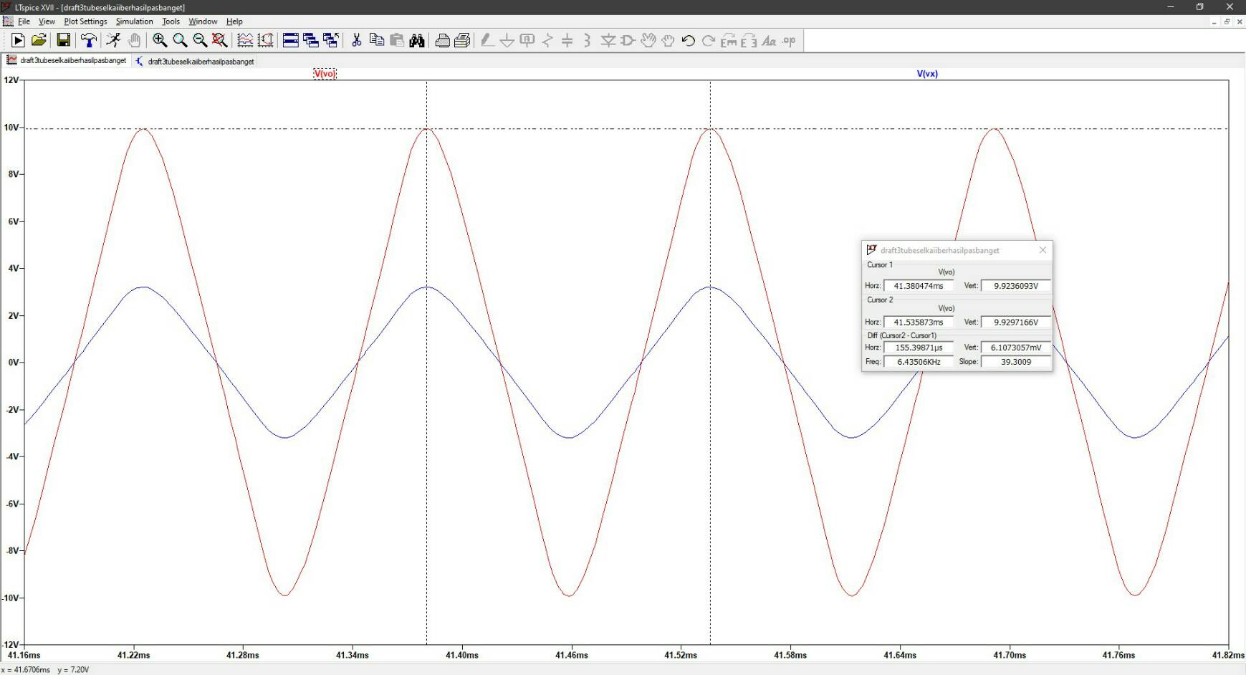
Hasil_Simulasi_Vout_Jadi.jpg
